sotatek-dev/SotaSoC/tb/riscv-tests/README.md

## References:
https://github.com/riscv-software-src/riscv-tests
https://github.com/ei9/cpu/tree/master
https://github.com/georgeyhere/Toast-RV32i/tree/main
