sotatek-dev/SotaSoC/rtl/peri/uart/uart_tx.v

// 
// Module: uart_tx 
// 
// Notes:
// - UART transmitter module.
//

module uart_tx(
input  wire         clk         , // Top level system clock input.
input  wire         resetn      , // Asynchronous active low reset.
input  wire [9:0]   divider     , // Clock divider: CLK_HZ / BIT_RATE
output wire         uart_txd    , // UART transmit pin.
output wire         uart_tx_busy, // Module busy sending previous item.
input  wire         uart_tx_en  , // Send the data on uart_tx_data
input  wire [PAYLOAD_BITS-1:0]   uart_tx_data  // The data to be sent
);

// --------------------------------------------------------------------------- 
// External parameters.
// 

//
// Number of data bits recieved per UART packet.
parameter   PAYLOAD_BITS    = 8;

//
// Number of stop bits indicating the end of a packet.
parameter   STOP_BITS       = 1;

// --------------------------------------------------------------------------- 
// Internal parameters.
// 

//
// Size of the registers which store sample counts and bit durations.
// Divider is 10 bits (0-1023), so we need 10 bits for cycle_counter
localparam       COUNT_REG_LEN      = 10;

// --------------------------------------------------------------------------- 
// Internal registers.
// 

//
// Internally latched value of the uart_txd line. Helps break long timing
// paths from the logic to the output pins.
reg txd_reg;

//
// Storage for the serial data to be sent.
reg [PAYLOAD_BITS-1:0] data_to_send;

//
// Counter for the number of cycles over a packet bit.
reg [COUNT_REG_LEN-1:0] cycle_counter;

//
// Counter for the number of sent bits of the packet.
reg [3:0] bit_counter;

//
// Current and next states of the internal FSM.
reg [2:0] fsm_state;
reg [2:0] n_fsm_state;

localparam FSM_IDLE = 0;
localparam FSM_START= 1;
localparam FSM_SEND = 2;
localparam FSM_STOP = 3;


// --------------------------------------------------------------------------- 
// FSM next state selection.
// 

assign uart_tx_busy = fsm_state != FSM_IDLE;
assign uart_txd     = txd_reg;

wire next_bit     = cycle_counter == divider;
wire payload_done = bit_counter   == PAYLOAD_BITS  ;
wire stop_done    = bit_counter   == STOP_BITS && fsm_state == FSM_STOP;

//
// Handle picking the next state.
always @(*) begin : p_n_fsm_state
    case(fsm_state)
        FSM_IDLE : n_fsm_state = uart_tx_en   ? FSM_START: FSM_IDLE ;
        FSM_START: n_fsm_state = next_bit     ? FSM_SEND : FSM_START;
        FSM_SEND : n_fsm_state = payload_done ? FSM_STOP : FSM_SEND ;
        FSM_STOP : n_fsm_state = stop_done    ? FSM_IDLE : FSM_STOP ;
        default  : n_fsm_state = FSM_IDLE;
    endcase
end

// --------------------------------------------------------------------------- 
// Internal register setting and re-setting.
// 

//
// Handle updates to the sent data register.
integer i;
always @(posedge clk) begin : p_data_to_send
    if(!resetn) begin
        data_to_send <= {PAYLOAD_BITS{1'b0}};
    end else if(fsm_state == FSM_IDLE && uart_tx_en) begin
        data_to_send <= uart_tx_data;
    end else if(fsm_state       == FSM_SEND       && next_bit ) begin
        for ( i = PAYLOAD_BITS-2; i >= 0; i = i - 1) begin
            data_to_send[i] <= data_to_send[i+1];
        end
    end
end


//
// Increments the bit counter each time a new bit frame is sent.
always @(posedge clk) begin : p_bit_counter
    if(!resetn) begin
        bit_counter <= 4'b0;
    end else if(fsm_state != FSM_SEND && fsm_state != FSM_STOP) begin
        bit_counter <= 4'b0;
    end else if(fsm_state == FSM_SEND && n_fsm_state == FSM_STOP) begin
        bit_counter <= 4'b0;
    end else if(fsm_state == FSM_STOP&& next_bit) begin
        bit_counter <= bit_counter + 1'b1;
    end else if(fsm_state == FSM_SEND && next_bit) begin
        bit_counter <= bit_counter + 1'b1;
    end
end


//
// Increments the cycle counter when sending.
always @(posedge clk) begin : p_cycle_counter
    if(!resetn) begin
        cycle_counter <= {COUNT_REG_LEN{1'b0}};
    end else if(next_bit) begin
        cycle_counter <= {COUNT_REG_LEN{1'b0}};
    end else if(fsm_state == FSM_START || 
                fsm_state == FSM_SEND  || 
                fsm_state == FSM_STOP   ) begin
        cycle_counter <= cycle_counter + 1'b1;
    end
end


//
// Progresses the next FSM state.
always @(posedge clk) begin : p_fsm_state
    if(!resetn) begin
        fsm_state <= FSM_IDLE;
    end else begin
        fsm_state <= n_fsm_state;
    end
end


//
// Responsible for updating the internal value of the txd_reg.
always @(posedge clk) begin : p_txd_reg
    if(!resetn) begin
        txd_reg <= 1'b1;
    end else if(fsm_state == FSM_IDLE) begin
        txd_reg <= 1'b1;
    end else if(fsm_state == FSM_START) begin
        txd_reg <= 1'b0;
    end else if(fsm_state == FSM_SEND) begin
        txd_reg <= data_to_send[0];
    end else if(fsm_state == FSM_STOP) begin
        txd_reg <= 1'b1;
    end
end

endmodule
