sotatek-dev/SotaSoC/rtl/test_mem_ctl.v

/* Test Memory Controller for RV32I SoC
 * 
 * This test controller:
 * - Loads program binary from file at startup
 * - Serves instruction fetch requests from loaded memory
 * - Handles data memory operations in internal RAM
 * - Simulates realistic memory access delays
 * - Maintains same interface as mem_ctl.v for drop-in replacement
 * - SPI signals are present but unused (kept for compatibility)
 * - Supports byte, halfword, and word writes (SB, SH, SW) via write_flag
 * - SEQUENTIAL ACCESS: Only instruction OR data access at a time
 * - DATA PRIORITY: Data memory access has higher priority than instruction fetch
 * 
 * Memory Map:
 * 0x00000000 - 0x00001FFF: Program Memory (loaded from file) - 8KB
 * 0x00002000 - 0x00003FFF: Data RAM (8KB)
 */

`include "debug_defines.vh"

module mem_ctl #(
    parameter FLASH_SIZE = 32'h00002000,
    parameter PSRAM_SIZE = 32'h00002000,
    parameter UART_BASE_ADDR = 32'h40000000,
    parameter UART_SIZE = 16,
    parameter GPIO_BASE_ADDR = 32'h40001000,
    parameter GPIO_SIZE = 5
) (
    input wire clk,
    input wire rst_n,
    
    // Core interface
    input wire [31:0] instr_addr,
    output reg [31:0] instr_data,
    output reg instr_ready,
    
    input wire [31:0] mem_addr,
    input wire [31:0] mem_wdata,
    input wire [2:0] mem_flag,    // funct3 from store instruction: 000=SB, 001=SH, 010=SW
    input wire mem_we,
    input wire mem_re,
    output reg [31:0] mem_rdata,
    output reg mem_ready,
    
    // UART TX interface
    output wire uart_tx_en,
    input wire uart_tx_busy,
    output wire [7:0] uart_tx_data,

    // UART RX interface
    output wire uart_rx_en,
    input wire uart_rx_break,
    input wire uart_rx_valid,
    input wire [7:0] uart_rx_data,

    // GPIO interface
    output wire [GPIO_SIZE-1:0] gpio_out,
    
    // Shared SPI interface (unused in test controller)
    output reg flash_cs_n,
    output reg ram_cs_n,
    output reg spi_sclk,
    output reg spi_mosi,
    input wire spi_miso
);

    // `define USE_MEMORY_DELAY 1
    // Memory access delay constants
    parameter INSTR_FETCH_DELAY = 3;  // Instruction fetch takes 3 cycles
    parameter DATA_ACCESS_DELAY = 2;  // Data read/write takes 2 cycles
    
    parameter TOTAL_MEM_SIZE = FLASH_SIZE + PSRAM_SIZE;  // Total memory size in bytes

    reg [7:0] unified_mem [0:TOTAL_MEM_SIZE-1];  // Single byte-addressed memory array
    reg [31:0] combined_mem [0:(TOTAL_MEM_SIZE/4)-1];  // Temporary array for loading

    reg [GPIO_SIZE-1:0] gpio_reg;
    
    // UART controller interface signals
    wire [31:0] uart_mem_rdata;
    
    // Address mapping
    // Allow access to both program and data memory,
    // because there are some tests that write instructions to data memory then jump to that address
    // wire is_prog_addr = (instr_addr < FLASH_SIZE);
    wire is_prog_addr = (instr_addr < FLASH_SIZE + PSRAM_SIZE);
    wire is_data_addr = (mem_addr >= FLASH_SIZE) && (mem_addr < FLASH_SIZE + PSRAM_SIZE);
    wire is_uart_addr = (mem_addr >= UART_BASE_ADDR) && (mem_addr < UART_BASE_ADDR + UART_SIZE);
    wire gpio_request = is_data_addr && (mem_addr == GPIO_BASE_ADDR);

    // ========================================
    // UNIFIED ACCESS CONTROLLER
    // ========================================
    // Controls sequential access with data memory priority
    reg [2:0] access_state;
    reg [2:0] access_delay_counter;
    reg [31:0] current_addr;
    reg [31:0] current_wdata;
    reg [2:0] current_flag;
    reg current_we;
    reg current_is_instr;

    localparam ACCESS_IDLE = 3'b000;
    localparam ACCESS_ACTIVE = 3'b001;
    
    // Request signals
    wire data_request = mem_we || mem_re;
    wire instr_request = (instr_addr != current_addr) || !instr_ready;
    
    // Priority logic: data has higher priority
    wire start_data_access = data_request && (access_state == ACCESS_IDLE);
    wire start_instr_access = instr_request && (access_state == ACCESS_IDLE) && !data_request;

    // Memory initialization - load program from file
    integer i;
    reg [8*256:1] bin_file;  // String to hold filename
    initial begin
        
        // Initialize memory to zero
        for (i = 0; i < TOTAL_MEM_SIZE; i = i + 1) begin
            unified_mem[i] = 8'h00;
        end
        
        // Load program binary if file exists
        if ($value$plusargs("BIN_FILE=%s", bin_file)) begin
            // Load entire bin file into temporary combined memory
            $readmemh(bin_file, combined_mem);
            `DEBUG_PRINT(("Test Memory Controller: Loaded combined bin file %s", bin_file));
        end else begin
            // Load default test program
            $readmemh("program.bin", combined_mem);
            `DEBUG_PRINT(("Test Memory Controller: Loaded default test program"));
        end

        // Copy to unified memory (convert from 32-bit words to bytes)
        for (i = 0; i < TOTAL_MEM_SIZE/4; i = i + 1) begin
            unified_mem[i*4 + 0] = combined_mem[i][7:0];
            unified_mem[i*4 + 1] = combined_mem[i][15:8];
            unified_mem[i*4 + 2] = combined_mem[i][23:16];
            unified_mem[i*4 + 3] = combined_mem[i][31:24];
        end

        `DEBUG_PRINT(("  - Program memory: %0d bytes (0x00000000-0x%08h)", FLASH_SIZE, FLASH_SIZE - 1));
        `DEBUG_PRINT(("  - Data memory: %0d bytes (0x00002000-0x%08h)", PSRAM_SIZE, 32'h00002000 + PSRAM_SIZE - 1));

        `DEBUG_PRINT(("Test Memory Controller: Memory initialization complete"));
        `DEBUG_PRINT(("  - Instruction fetch delay: %0d cycles", INSTR_FETCH_DELAY));
        `DEBUG_PRINT(("  - Data access delay: %0d cycles", DATA_ACCESS_DELAY));
    end

    // GPIO register access handling (immediate response)
    assign gpio_out = gpio_reg;
    
    // UART Controller instance
    uart_ctl uart_ctl_inst (
        .clk(clk),
        .rst_n(rst_n),
        
        // Memory-mapped interface
        .mem_addr(mem_addr),
        .mem_wdata(mem_wdata),
        .mem_we(mem_we),
        .mem_re(mem_re),
        .mem_rdata(uart_mem_rdata),
        
        // UART TX interface
        .uart_tx_en(uart_tx_en),
        .uart_tx_data(uart_tx_data),
        .uart_tx_busy(uart_tx_busy),
        
        // UART RX interface
        .uart_rx_en(uart_rx_en),
        .uart_rx_break(uart_rx_break),
        .uart_rx_valid(uart_rx_valid),
        .uart_rx_data(uart_rx_data)
    );

    `ifndef USE_MEMORY_DELAY
    // Instruction fetch handling
    always @(negedge clk or negedge rst_n) begin
        if (!rst_n) begin
            instr_data <= 32'h00000000;
            instr_ready <= 1'b0;
            // Keep SPI signals in safe state
            flash_cs_n <= 1'b1;
            ram_cs_n <= 1'b1;
            spi_sclk <= 1'b0;
            spi_mosi <= 1'b0;
        end else begin
            if (is_prog_addr) begin
                // Read 32-bit word from byte memory (little-endian)
                instr_data <= {unified_mem[instr_addr + 3], unified_mem[instr_addr + 2], 
                              unified_mem[instr_addr + 1], unified_mem[instr_addr + 0]};
                instr_ready <= 1'b1;
                
                `DEBUG_PRINT(("Time %0t: TEST_MEM - Instruction fetch: addr=0x%h, data=0x%h", 
                         $time, instr_addr, {unified_mem[instr_addr + 3], unified_mem[instr_addr + 2], 
                                            unified_mem[instr_addr + 1], unified_mem[instr_addr + 0]}));
            end // is_prog_addr || is_data_addr
        end // rst_n
    end
    
    // Data memory handling
    always @(negedge clk or negedge rst_n) begin
        if (!rst_n) begin
            mem_rdata <= 32'h00000000;
            mem_ready <= 1'b0;
            gpio_reg <= {GPIO_SIZE{1'b0}};
        end else begin
        
            if (is_uart_addr) begin
                // UART requests are handled by uart_ctl module
                // Just forward the response
                mem_rdata <= uart_mem_rdata;
                mem_ready <= 1'b1;
            end

            if (gpio_request) begin
                if (mem_we) begin
                    gpio_reg <= mem_wdata[GPIO_SIZE-1:0];
                end else begin
                    mem_rdata <= {27'b0, gpio_reg};
                end
                mem_ready <= 1'b1;
                access_state <= ACCESS_IDLE;
            end
        
            if (is_data_addr) begin
                mem_ready <= 1'b0;

                if (mem_we) begin
                    // Write operation using byte enable signals based on write_flag
                    // write_flag corresponds to funct3 field:
                    // 3'b000 → SB (Store Byte)
                    // 3'b001 → SH (Store Halfword)
                    // 3'b010 → SW (Store Word)

                    unified_mem[mem_addr + 0] <= mem_wdata[7:0];
                    if (mem_flag == 3'b001 || mem_flag == 3'b010) unified_mem[mem_addr + 1] <= mem_wdata[15:8];
                    if (mem_flag == 3'b010) unified_mem[mem_addr + 2] <= mem_wdata[23:16];
                    if (mem_flag == 3'b010) unified_mem[mem_addr + 3] <= mem_wdata[31:24];
                    
                    mem_ready <= 1'b1;
                    
                    case (mem_flag)
                        3'b000: `DEBUG_PRINT(("Time %0t: TEST_MEM - SB (Store Byte): addr=0x%h, data=0x%02h, mem_flag=0x%h", 
                                        $time, mem_addr, mem_wdata[7:0], mem_flag));
                        3'b001: `DEBUG_PRINT(("Time %0t: TEST_MEM - SH (Store Halfword): addr=0x%h, data=0x%04h, mem_flag=0x%h", 
                                        $time, mem_addr, mem_wdata[15:0], mem_flag));
                        3'b010: `DEBUG_PRINT(("Time %0t: TEST_MEM - SW (Store Word): addr=0x%h, data=0x%08h, mem_flag=0x%h", 
                                        $time, mem_addr, mem_wdata, mem_flag));
                        default: `DEBUG_PRINT(("Time %0t: TEST_MEM - Unknown store type: mem_flag=0x%h, addr=0x%h, data=0x%08h", 
                                         $time, mem_flag, mem_addr, mem_wdata));
                    endcase
                end else if (mem_re) begin
                    // Read operation - 32-bit word read from byte memory
                    mem_rdata <= {unified_mem[mem_addr + 3], unified_mem[mem_addr + 2], 
                                  unified_mem[mem_addr + 1], unified_mem[mem_addr + 0]};
                    mem_ready <= 1'b1;
                    
                    `DEBUG_PRINT(("Time %0t: TEST_MEM - Data read: addr=0x%h, data=0x%h", 
                             $time, mem_addr, {unified_mem[mem_addr + 3], unified_mem[mem_addr + 2], 
                                               unified_mem[mem_addr + 1], unified_mem[mem_addr + 0]}));
                end // mem_re
            end // is_data_addr
        end // rst_n
    end
    `endif // !USE_MEMORY_DELAY
    
    `ifdef USE_MEMORY_DELAY
    // Unified memory access handling with data priority
    always @(posedge clk or negedge rst_n) begin
        if (!rst_n) begin
            instr_data <= 32'h00000000;
            instr_ready <= 1'b0;
            mem_rdata <= 32'h00000000;
            mem_ready <= 1'b0;
            access_state <= ACCESS_IDLE;
            access_delay_counter <= 3'b0;
            current_addr <= 32'h0;
            current_wdata <= 32'h0;
            current_flag <= 3'b0;
            current_we <= 1'b0;
            current_is_instr <= 1'b0;

            gpio_reg <= {GPIO_SIZE{1'b0}};

            // Keep SPI signals in safe state
            flash_cs_n <= 1'b1;
            ram_cs_n <= 1'b1;
            spi_sclk <= 1'b0;
            spi_mosi <= 1'b0;
        end else begin

            case (access_state)
                ACCESS_IDLE: begin
                    // Clear ready signals when starting new access
                    // if (start_data_access || start_instr_access) begin
                        instr_ready <= 1'b0;
                        mem_ready <= 1'b0;
                    // end
                    
                    // Priority 1: Data memory access (higher priority)
                    if (start_data_access) begin
                        current_addr <= mem_addr;
                        current_wdata <= mem_wdata;
                        current_flag <= mem_flag;
                        current_we <= mem_we;
                        current_is_instr <= 1'b0;
                        access_state <= ACCESS_ACTIVE;
                        access_delay_counter <= DATA_ACCESS_DELAY - 1;
                        if (is_uart_addr) begin
                            // UART requests are handled by uart_ctl module
                            // Just forward the response
                            mem_rdata <= uart_mem_rdata;
                            mem_ready <= 1'b1;
                            access_state <= ACCESS_IDLE;
                        end
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
