sotatek-dev/SotaSoC/tb/cocotb/test_rv32i_core.py

import cocotb
from cocotb.triggers import RisingEdge, Timer
from cocotb.clock import Clock
import test_utils
from test_utils import do_test, CYCLES_PER_INSTRUCTION, NOP_INSTR

@cocotb.test()
async def test_reset(dut):
    """Test that the core resets properly"""
    clock = Clock(dut.clk, 10, unit="ns")
    cocotb.start_soon(clock.start())
    
    # Reset the core
    dut.rst_n.value = 0
    await Timer(20, unit="ns")
    dut.rst_n.value = 1
    
    # Check that PC starts at reset address
    await RisingEdge(dut.clk)
    assert dut.core.o_instr_addr.value == 0x00000000, f"PC should be 0x00000000, got 0x{dut.o_instr_addr.value.integer:08x}"

@cocotb.test()
async def test_nop_instruction(dut):
    """Test NOP instruction execution"""
    clock = Clock(dut.clk, 10, unit="ns")
    cocotb.start_soon(clock.start())
    
    # Reset
    dut.rst_n.value = 0
    await Timer(20, unit="ns")
    dut.rst_n.value = 1
    
    # Provide NOP instruction
    dut.instr_data.value = 0x00000013  # NOP: addi x0, x0, 0
    dut.mem_data.value = 0x00000000
    dut.instr_ready.value = 1
    
    # Let it execute for a few cycles
    for _ in range(10):
        await RisingEdge(dut.clk)
        # PC should increment by 4 each cycle
        expected_pc = 0x00000000 + (_ * 4)
        assert dut.core.o_instr_addr.value == expected_pc, f"PC should be 0x{expected_pc:08x}, got 0x{dut.o_instr_addr.value.integer:08x}"

@cocotb.test()
async def test_addi_instruction(dut):
    """Test ADDI instruction"""
    clock = Clock(dut.clk, 10, unit="ns")
    cocotb.start_soon(clock.start())
    
    # Reset
    dut.rst_n.value = 0
    
    # ADDI x1, x0, 5 (addi x1, x0, 5)
    dut.instr_data.value = 0x00500093
    dut.mem_data.value = 0x00000000
    dut.instr_ready.value = 1
    
    await Timer(20, unit="ns")
    dut.rst_n.value = 1
    
    # Execute for several cycles to see the pipeline
    for _ in range(CYCLES_PER_INSTRUCTION):
        await RisingEdge(dut.clk)

    assert dut.core.register_file.registers[1].value == 5, f"Register x1 should be 5, got 0x{dut.core.register_file.registers[1].value.integer:08x}"
    # print("All register values:")
    # for i in range(32):  # RV32I has 32 registers (x0-x31)
    #     reg_value = dut.core.register_file.registers[i].value.integer
    #     print(f"  x{i}: 0x{reg_value:08x} ({reg_value})")

@cocotb.test()
async def test_add_instruction(dut):
    """Test ADD instruction"""
    clock = Clock(dut.clk, 10, unit="ns")
    cocotb.start_soon(clock.start())
    
    # Reset
    dut.rst_n.value = 0
    await Timer(20, unit="ns")
    dut.rst_n.value = 1
    
    # First, set up values for x1 and x2 using ADDI
    # ADDI x1, x0, 5 (addi x1, x0, 5)
    dut.instr_data.value = 0x00500093
    dut.mem_data.value = 0x00000000
    dut.instr_ready.value = 1
    
    # Execute for several cycles to complete the ADDI
    for _ in range(CYCLES_PER_INSTRUCTION):
        await RisingEdge(dut.clk)

    # ADDI x2, x0, 10 (addi x2, x0, 10)
    dut.instr_data.value = 0x00a00113
    dut.mem_data.value = 0x00000000
    
    # Execute for several cycles to complete the ADDI
    for _ in range(CYCLES_PER_INSTRUCTION):
        await RisingEdge(dut.clk)

    # Now test ADD x3, x1, x2 (add x3, x1, x2)
    dut.instr_data.value = 0x002081B3
    dut.mem_data.value = 0x00000000
    
    # Execute for several cycles to complete the ADD
    for _ in range(CYCLES_PER_INSTRUCTION):
        await RisingEdge(dut.clk)
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
