sotatek-dev/SotaSoC/(commit log)

2025-06-26 Fix some instruction tests: ADDI, ADD, LW, SW
    [rv32e_alu.v, rv32e_core.v, rv32e_register.v, test_rv32e_core.py, test_rv32e_core_tb.v]
2025-07-04 Add and fix jump tests
    [rv32e_core.sv, test_rv32e_core.py, test_rv32e_core_tb.sv]
2025-07-05 Add assembly tests
2025-07-05 Fix LUI instruction: alu_a is always 0
    [rv32i_core.sv]
2025-07-05 Fix test mem controller
    [test_mem_ctl.v]
2025-07-05 Fix test mem controller: store instructions
    [mem_ctl.v, rv32i_core.sv, test_mem_ctl.v]
2025-07-06 Fix test mem controller: fence instruction
    [test_mem_ctl.v]
2025-07-06 Fix sb and sh tests
    [test_rv32i_core.py]
2025-07-06 Stall pipeline if instruction or memory is not ready
    [rv32i_core.sv, test_rv32i_core.py, test_rv32i_core_hazard.py, test_rv32i_core_jump.py, test_rv32i_core_tb.sv, test_utils.py]
2025-07-07 Add UART
2025-07-08 Add uart test
2025-07-09 Move UART logic to a task. Test UART on Artix 7.
2025-07-17 Add more uart test
2025-07-19 Refactor UART
2025-08-13 Implement spi memory
2025-08-15 Add UART to mem_ctl
2025-09-17 Fix SPI memory
2025-09-18 Add CPU error flag
    [rv32i_core.sv, spi_master.v, test_spi_mem.py]
2025-09-18 Switch instruction memory to little endian
2025-09-22 Fix memory endian and refactor paramters
    [mem_ctl.v, test_mem_ctl.v, test_soc_tb.sv, test_spi_mem.py, top.v]
2025-09-28 Add CPU error output and update vivado project
    [rv32e.xdc, top.v]
2025-11-06 Implement uart ctl
2025-11-06 Fix alu op size
    [rv32i_alu.v]
2026-01-06 Fix bug writing to gpio or uart
    [mem_ctl.v]
2026-01-07 Fix bugs and improve spi master
    [mem_ctl.v, spi_master.v, spi_memory_utils.py]
2026-01-07 Fix bugs in uart module
    [mem_ctl.v, test_uart_rx.py, uart_ctl.v]
2026-01-07 Refactor spi master
2026-01-09 Timer interrupt
2026-01-10 Timer interrupt part 2
2026-01-16 Split alu and branch to 2 stages. Rename core regs and wires
2026-01-19 Implement PWM
2026-01-19 Rerfactor UART
2026-01-20 Multiple UART instances (configurable)
2026-01-21 Implement GPIO module and pin mux
2026-01-22 Implement i2c module part 1 (haven't tested yet)
2026-01-23 Improve instruction memory: prevent idle cycles
    [qspi_master.v, spi_master.v]
2026-01-23 Switch from RV32I to RV32E
2026-01-26 Fix QSPI RAM 4-4-4
    [qspi_master.v, qspi_memory_utils.py]
2026-01-26 Stop spi clock immediately when receiving stop signal
2026-01-26 Reset flash on system reset
    [qspi_master.v]
2026-01-26 Fix bug reading data from flash chip
    [mem_ctl.sv, qspi_master.v, qspi_memory_utils.py, spi_master.v]
2026-01-27 Implement SPI master
2026-01-29 Add I2C tests
2026-01-31 Update pin for vivado
2026-01-31 Implement external interrupt
2026-02-01 Reduce timing risk on interrupt
2026-02-02 Implement SPI CPOL and CPHA
2026-02-03 SPI: increase buffer size to 2 bytes
2026-02-03 SPI: increase buffer size to 4 bytes
2026-02-04 Fix warning in uart module
    [uart_rx.v, uart_tx.v]
2026-02-06 Update pin mux
2026-02-06 Add delay config to qspi, allow sample data after 1, 2, 3 cycles
2026-02-11 Fix mem_ctl: update peripherals access condition
    [mem_ctl.sv]
2026-02-12 Switch from RV32E to RV32I
2026-02-12 Update I2C and SPI tests
2026-02-12 Update PWM document
